robot-army/laser-dac-diff-driver/laser-dac-diff-driver-B_Cu.pdf

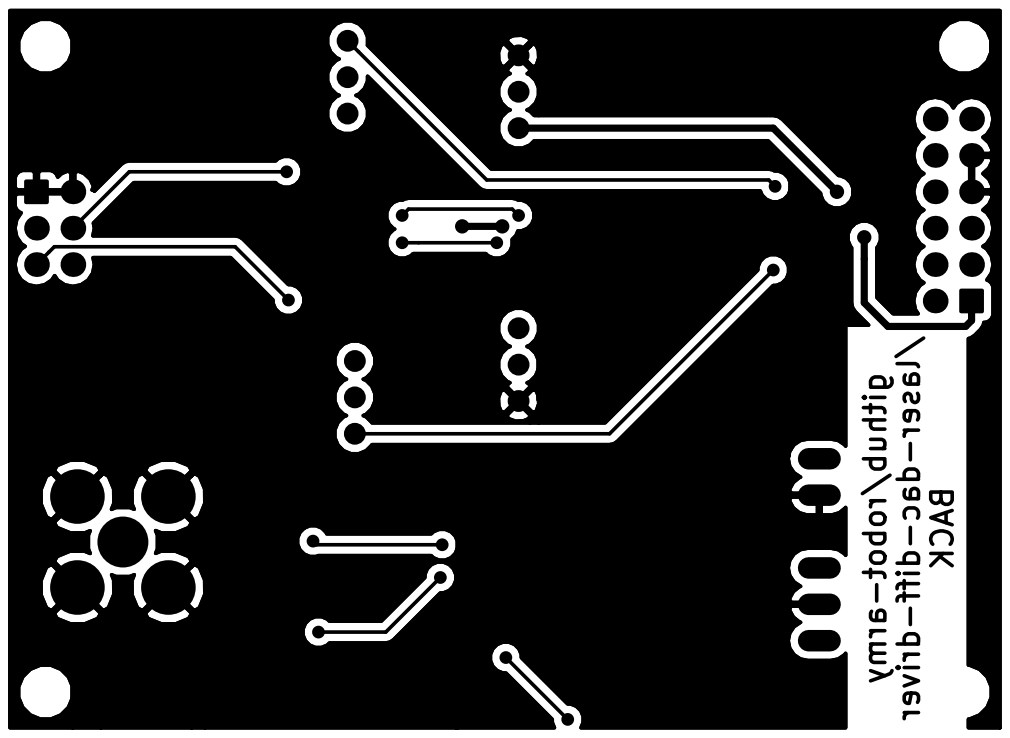
[picture p1: page 1]
