robot-army/laser-dac-diff-driver/laser-dac-diff-driver-F_Cu.pdf

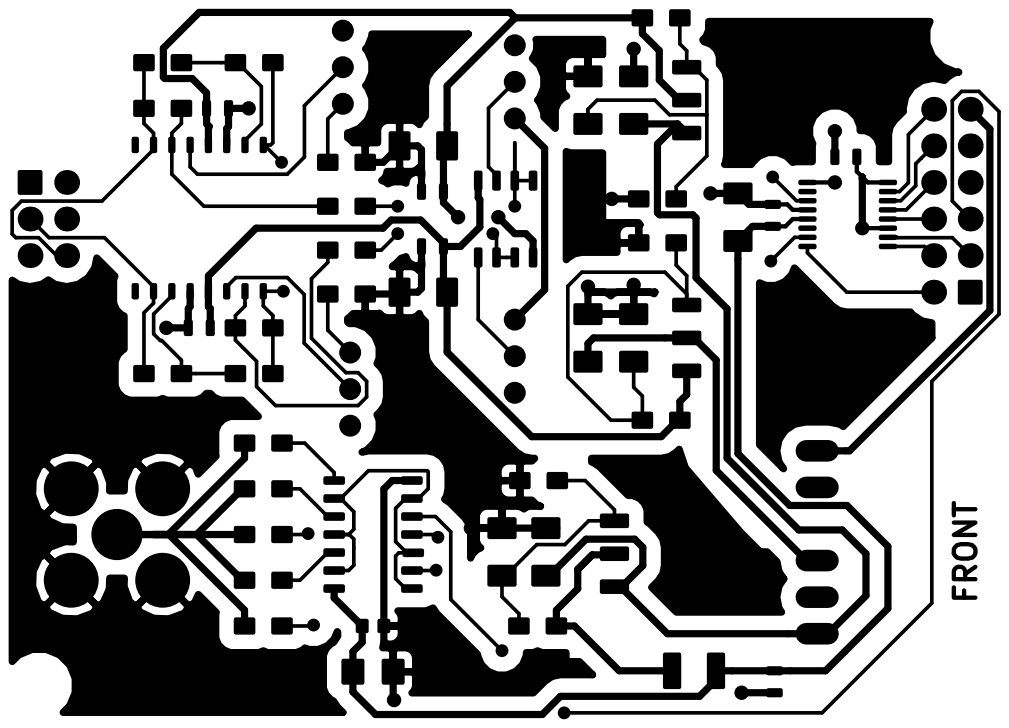
[picture p2: page 1]
