robot-army/laser-dac-diff-driver/laser-dac-diff-driver-F_SilkS.pdf

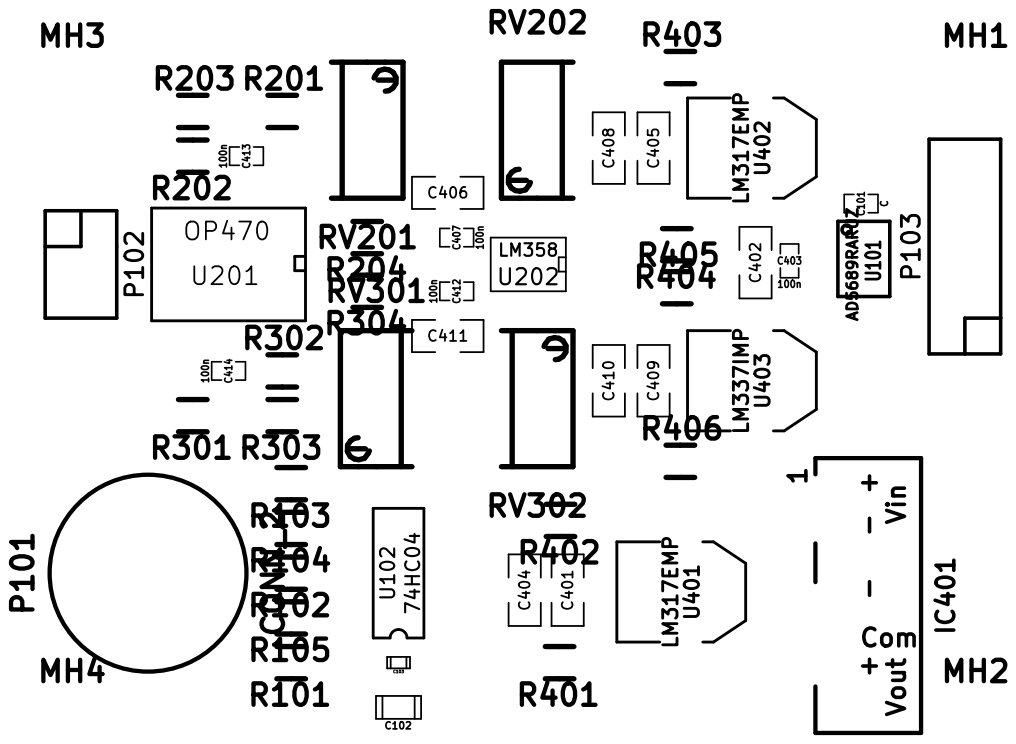
[picture p7: page 1]
