robot-army/laser-dac-diff-driver/(list of files, drawings)

Other design files:
laser-dac-diff-driver.dsn
