robot-army/laser-dac-diff-driver/laser-dac-diff-driver.kicad_pcb

## KiCad design laser-dac-diff-driver.kicad_pcb (2014-03-12)

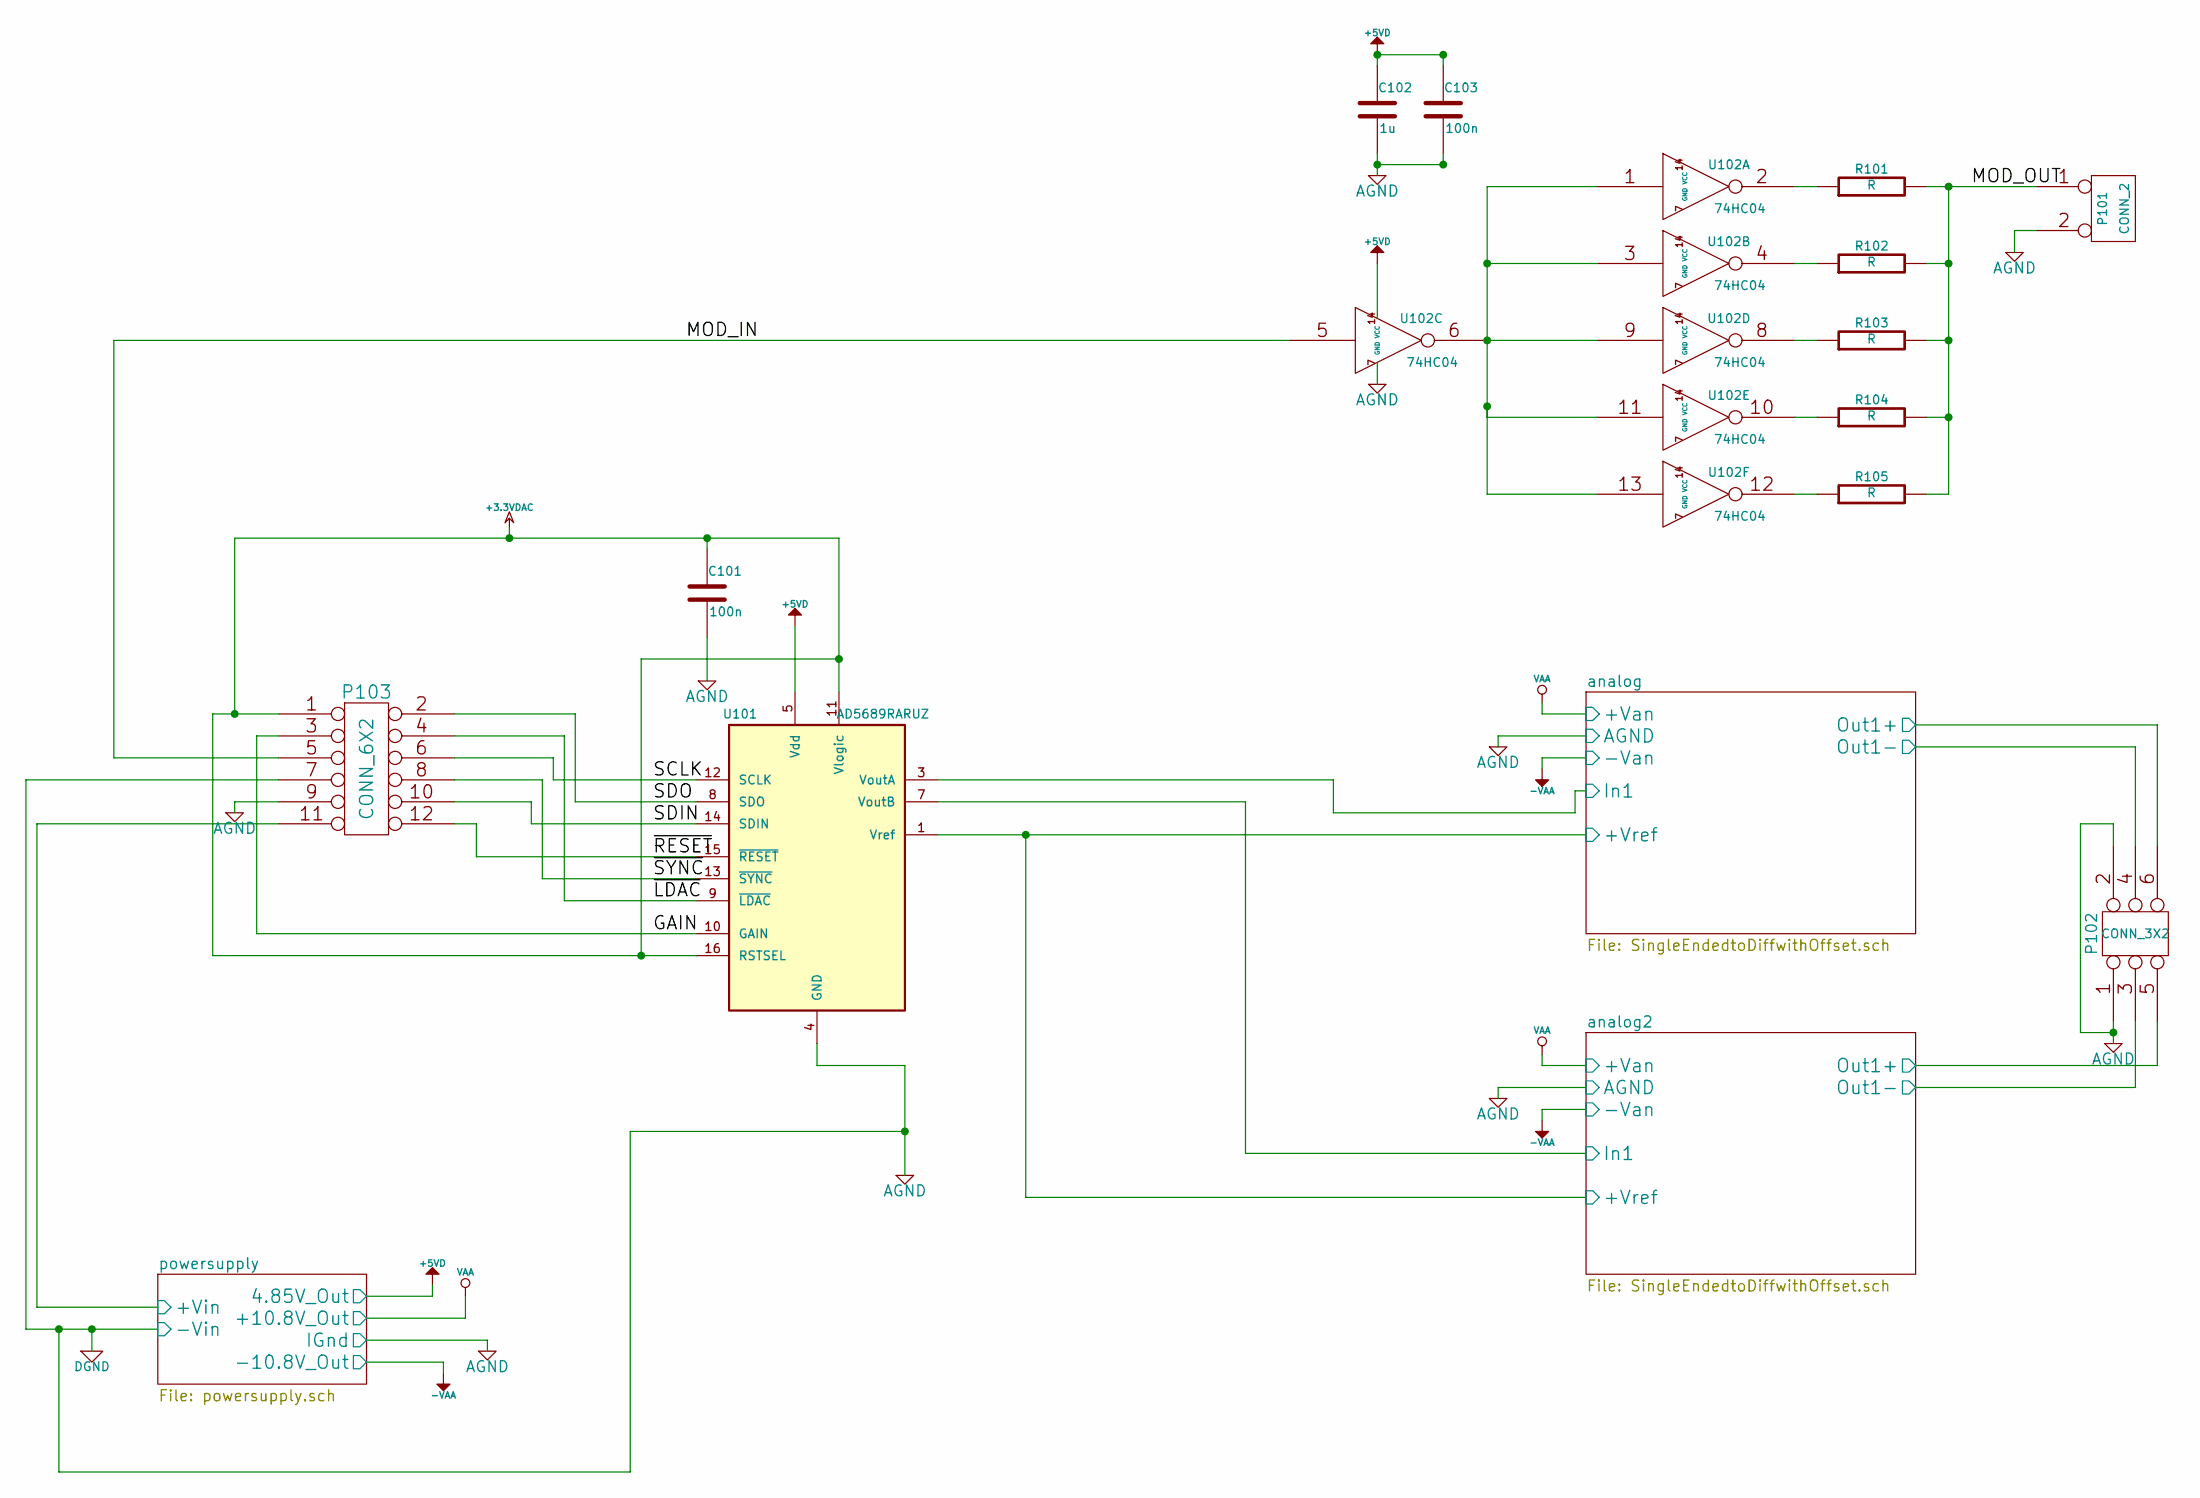
[picture p8: schematic laser-dac-diff-driver.sch]

Parts:
C101, C103: 100n
C102: 1u
P101: CONN_2
P102: CONN_3X2
P103: CONN_6X2
R101, R102, R103, R104, R105: R
U101: AD5689RARUZ
U102: 74HC04

Connections:
+3.3VDAC: C101.1, P103.1, U101.11 (Vlogic), U101.16 (RSTSEL)
+5VD: C102.1, C103.1, U101.5 (Vdd), U102.14 (VCC); also elsewhere on the board
/GAIN: P103.3, U101.10 (GAIN)
/MOD_IN: P103.5, U102.5
/MOD_OUT: P101.1, R101.2, R102.2, R103.2, R104.2, R105.2
/SCLK: P103.6, U101.12 (SCLK)
/SDIN: P103.10, U101.14 (SDIN)
/SDO: P103.2, U101.8 (SDO)
/analog2/In1: U101.7 (VoutB); also elsewhere on the board
/analog2/Out1+: P102.5; also elsewhere on the board
/analog2/Out1-: P102.3; also elsewhere on the board
/analog/+Vref: U101.1 (Vref); also elsewhere on the board
/analog/In1: U101.3 (VoutA); also elsewhere on the board
/analog/Out1+: P102.6; also elsewhere on the board
/analog/Out1-: P102.4; also elsewhere on the board
/powersupply/+Vin: P103.11; also elsewhere on the board
/~LDAC: P103.4, U101.9 (~LDAC)
/~RESET: P103.12, U101.15 (~RESET)
/~SYNC: P103.8, U101.13 (~SYNC)
AGND: C101.2, C102.2, C103.2, P101.2 (PM), P102.1, P102.2, P103.7, P103.9, U101.4 (GND), U102.7 (GND); also elsewhere on the board
unnamed: R101.1, U102.2
unnamed: R102.1, U102.4
unnamed: R103.1, U102.8
unnamed: R104.1, U102.10
unnamed: R105.1, U102.12
unnamed: U102.1, U102.3, U102.6, U102.9, U102.11, U102.13

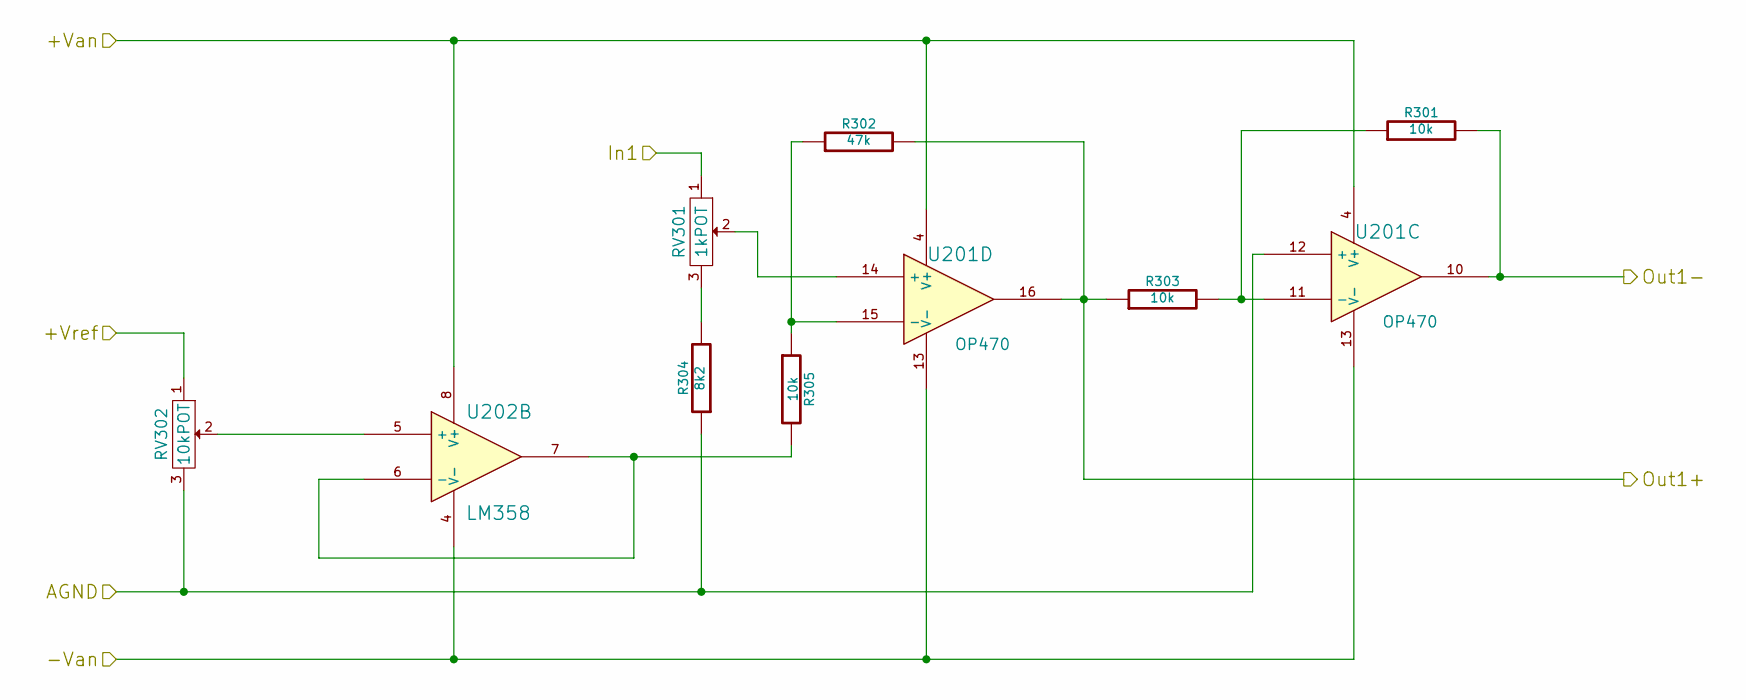
[picture p9: schematic SingleEndedtoDiffwithOffset.sch]

Parts:
R205: 10k
R301, R303: 10k
R302: 47k
R304: 8k2
RV301: 1kPOT
RV302: 10kPOT
U201: OP470
U202: LM358

Connections:
-VAA: U201.13 (V-), U202.4 (V-); also elsewhere on the board
/analog2/In1: RV301.1; also elsewhere on the board
/analog2/Out1+: R302.2, R303.1, U201.16; also elsewhere on the board
/analog2/Out1-: R301.2, U201.10; also elsewhere on the board
/analog/+Vref: RV302.1; also elsewhere on the board
/analog/Out1+: U201.7; also elsewhere on the board
/analog/Out1-: U201.1; also elsewhere on the board
AGND: R304.1, RV302.3, U201.3 (+), U201.12 (+); also elsewhere on the board
unnamed 32: U201.2 (-); also elsewhere on the board
unnamed: R301.1, R303.2, U201.11 (-)
unnamed: R304.2, RV301.3
unnamed 36: U201.5 (+); also elsewhere on the board
unnamed 37: U202.3 (+); also elsewhere on the board
unnamed: RV301.2, U201.14 (+)
unnamed: RV302.2, U202.5 (+)
VAA: U201.4 (V+), U202.8 (V+); also elsewhere on the board

Parts of its further copies:
R201, R203: 10k
R202: 47k
R204: 8k2
R305: 10k
RV201: 1kPOT
RV202: 10kPOT

Connections of its further copies:
/analog/+Vref: RV202.1; also elsewhere on the board
/analog/In1: RV201.1; also elsewhere on the board
/analog/Out1+: R202.2, R203.1; also elsewhere on the board
/analog/Out1-: R201.2; also elsewhere on the board
AGND: R204.1, RV202.3; also elsewhere on the board
unnamed 32: R201.1, R203.2; also elsewhere on the board
unnamed: R204.2, RV201.3
unnamed 36: RV201.2; also elsewhere on the board
unnamed 37: RV202.2; also elsewhere on the board

Schematic: powersupply.sch

Parts:
C401, C402, C405, C406, C410, C411: 1u
C403, C407, C412, C413, C414, C415: 100n
C404, C408, C409: 10u
IC401: DCDC-CONV_TRACO_TMH-XXXX_Dual_REVA_27MAR2011
L401: INDUCTOR
R401, R403, R406: 240R
R402: 680R
R404, R405: 1k8
U401, U402: LM317EMP; SOT-223
U403: LM337IMP; SOT-223

Connections:
+5VD: C402.1, C403.1, C415.1, L401.1; also elsewhere on the board
-VAA: C411.2, C412.2, C414.2, R406.2, U403.3 (OUT); also elsewhere on the board
/powersupply/+Vin: IC401.1 (+Vin); also elsewhere on the board
/powersupply/+Vout_unreg: C401.1, C405.1, IC401.6 (+Vout), U401.3 (IN), U402.3 (IN)
/powersupply/-Vout_unreg: C410.2, IC401.4 (-Vout), U403.2 (IN), U403.4
AGND: C401.2, C402.2, C403.2, C404.2, C405.2, C406.2, C407.2, C408.2, C409.1, C410.1, C411.1, C412.1, C413.2, C414.1, C415.2, IC401.2 (-Vin), IC401.5 (Common), R402.2, R404.2, R405.1; also elsewhere on the board
unnamed: C404.1, R401.2, R402.1, U401.1 (ADJ)
unnamed: C408.1, R403.2, R404.1, U402.1 (ADJ)
unnamed: C409.2, R405.2, R406.1, U403.1 (ADJ)
unnamed: L401.2, R401.1, U401.2 (OUT), U401.4
VAA: C406.1, C407.1, C413.1, R403.1, U402.2 (OUT), U402.4; also elsewhere on the board

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
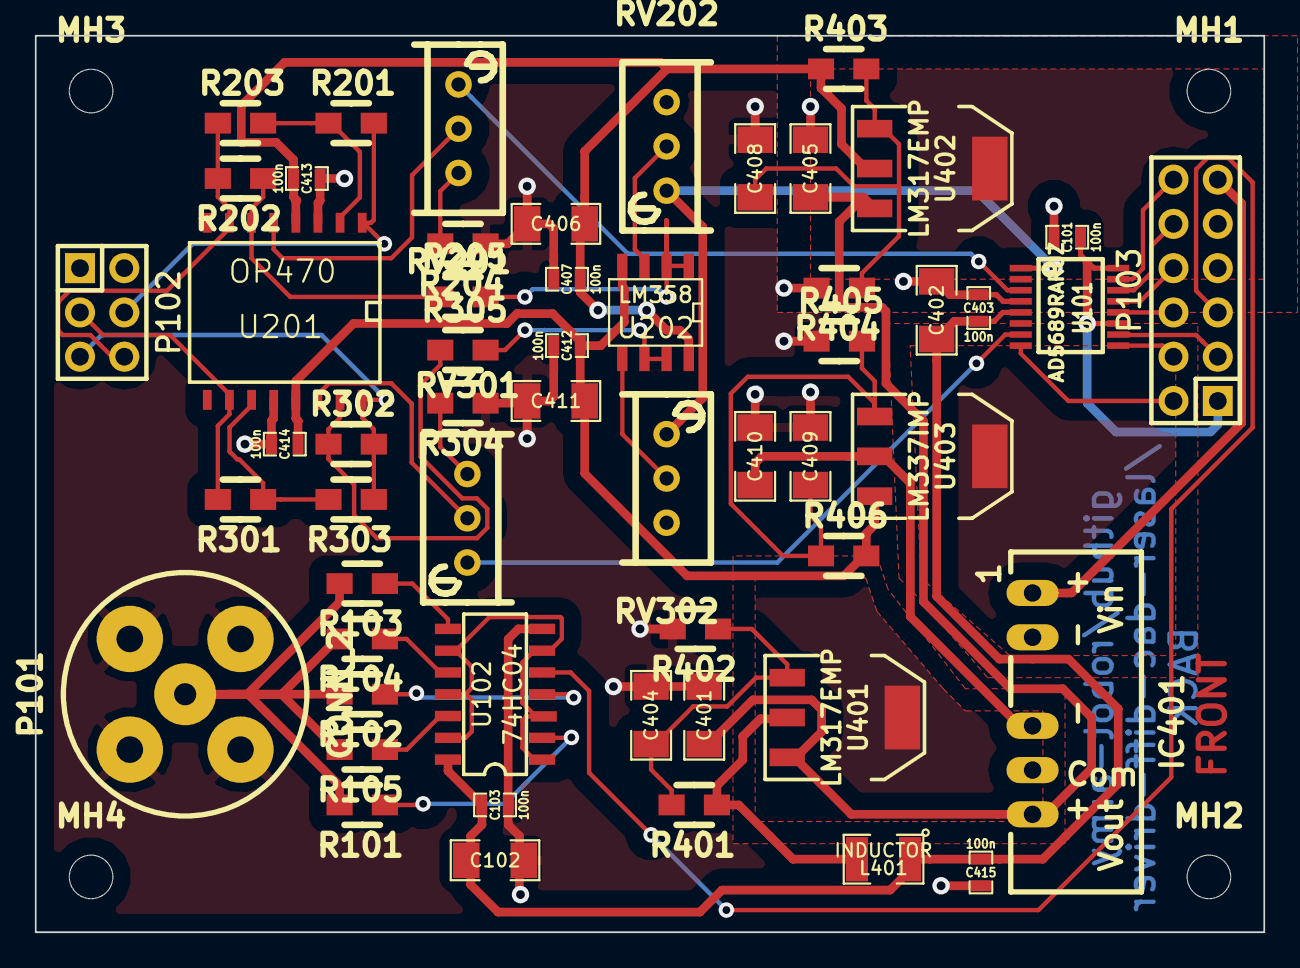
[picture p10: board laser-dac-diff-driver.kicad_pcb from above]

Board: 2 copper layers, 70.5 x 51.4 mm, 59 parts (0 on the bottom side), 46 nets.

Other parts of the board:
MH1, MH2, MH3, MH4: MountingHole_2-5mm_RevA_Date21Jun2010; MountingHole_2-5mm
