robot-army/laser-dac-diff-driver/(commit log)

2014-02-11 Adding schematic files and some custom libs
    [SingleEndedtoDiffwithOffset.sch, laser-dac-diff-driver.sch, powersupply.sch]
2014-02-11 Added more libraries and PCB layout starting point
    [laser-dac-diff-driver.dsn, laser-dac-diff-driver.kicad_pcb]
2014-02-20 Fixed decoupling on 78HC04, sorted out component positions
    [SingleEndedtoDiffwithOffset.sch, laser-dac-diff-driver.sch, powersupply.sch]
2014-02-26 Moved that thing over there
    [laser-dac-diff-driver.kicad_pcb]
2014-02-26 Revert "Moved that thing over there"
    This reverts commit 1365cc426dc2828d99ed98a10d059501ce40436a.
    [laser-dac-diff-driver.kicad_pcb]
2014-02-27 Fixed component footprint for ADC chip (pitch was slightly wrong??) Changed over BNC to nice small footprint
    [laser-dac-diff-driver.kicad_pcb]
2014-02-27 More component moves
    [laser-dac-diff-driver.kicad_pcb]
2014-02-27 Power supply position changes
    [laser-dac-diff-driver.kicad_pcb]
2014-02-28 Sorted out more component positions
    [laser-dac-diff-driver.kicad_pcb]
2014-02-28 Added extra small decoupling for reference. Pin-swapped and fixed pin numbers on digital input.
    [SingleEndedtoDiffwithOffset.sch, laser-dac-diff-driver.kicad_pcb, laser-dac-diff-driver.sch, powersupply.sch]
2014-03-01 Started layout, final-ish positions
    [laser-dac-diff-driver.kicad_pcb]
2014-03-01 Added net-names for unregulated DCDC outputs, more layout done
    [laser-dac-diff-driver.kicad_pcb, powersupply.sch]
2014-03-03 Made SVG schematics, started layout (but it's ugly, need to re-visit positions)
    [SingleEndedtoDiffwithOffset.sch, laser-dac-diff-driver.dsn, laser-dac-diff-driver.kicad_pcb]
2014-03-04 A few autorouter attempts and a new board layout (component positions). Removed voltage selector for MOD driver, 5V only now.
    [laser-dac-diff-driver-freerouting.kicad_pcb, laser-dac-diff-driver.dsn, laser-dac-diff-driver.sch]
2014-03-05 Almost there with layout
    [laser-dac-diff-driver.kicad_pcb]
2014-03-05 adding PDFs
    [laser-dac-diff-driver.kicad_pcb]
2014-03-05 Richard: add 10K pot between LM358 and OP470
    [SingleEndedtoDiffwithOffset.sch, laser-dac-diff-driver.sch, powersupply.sch]
2014-03-06 SENT TO FAB - also added LC filter to power from 5V to dac, copper pours for Reg heatsinks and missing resistors
    [SingleEndedtoDiffwithOffset.sch, laser-dac-diff-driver.kicad_pcb, laser-dac-diff-driver.sch, powersupply.sch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]
2014-03-12 Added bill of materials (shouldn't REALLY be any non-bom changes??)
    [laser-dac-diff-driver.csv, laser-dac-diff-driver.kicad_pcb, laser-dac-diff-driver.sch, laser-dac-diff-driver2.csv]
